maxsimmonds1337/RocketClock/software/helpers/artemis.jpg

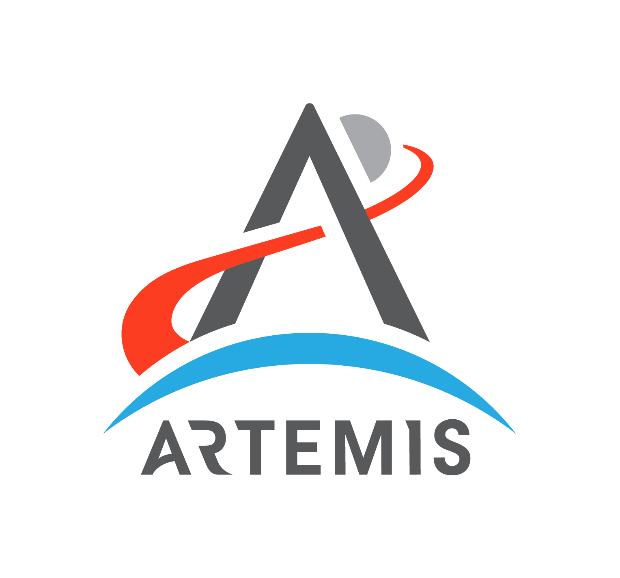
software/helpers/artemis.jpg
