maxsimmonds1337/RocketClock/manufacturing/RocketClock_BOM.csv

Reference | Qty | Value | DNP | Exclude from BOM | Exclude from Board | Footprint | Datasheet
BZ1 | 1 | CBT-09427-SMT-TR |  |  |  | footprints:CUI_CBT-09427-SMT | ~
C1,C2 | 2 | 1uF |  |  |  | Capacitor_SMD:C_0402_1005Metric_Pad0.74x0.62mm_HandSolder | ~
C3,C6,C8,C12,C14,C15 | 6 | 100nF |  |  |  | Capacitor_SMD:C_0402_1005Metric_Pad0.74x0.62mm_HandSolder | ~
C4,C5,C7,C11,C13 | 5 | 10uF |  |  |  | Capacitor_SMD:C_0402_1005Metric_Pad0.74x0.62mm_HandSolder | ~
C9,C10 | 2 | 33pF |  |  |  | Capacitor_SMD:C_0402_1005Metric_Pad0.74x0.62mm_HandSolder | ~
D1,D66 | 2 | D_Schottky |  |  |  | Diode_SMD:D_SOD-123 | ~
D2,D3,D4,D5,D6,D7,D8,D9,D10,D11,D12,D13,D14,D15,D16,D17,D18,D19,D20,D21,D22,D23,D24,D25,D26,D27,D28,D29,D30,D31,D32,D33,D34,D35,D36,D37,D38,D39,D40,D41,D42,D43,D44,D45,D46,D47,D48,D49,D50,D51,D52,D53,D54,D55,D56,D57,D58,D59,D60,D61,D62,D63,D64,D65 | 64 | Green |  |  |  | LED_SMD:LED_0805_2012Metric_Pad1.15x1.40mm_HandSolder | ~
J1 | 1 | PROG_CONN |  |  |  | Connector_PinHeader_1.00mm:PinHeader_1x06_P1.00mm_Vertical_SMD_Pin1Left | ~
J2 | 1 | Right Output Conn |  |  |  | Package_SO:MagConn | ~
J3 | 1 | Left Input Conn |  |  |  | Package_SO:MagConn | ~
JP1 | 1 | SolderJumper_2_Bridged |  | Excluded from BOM |  | Jumper:SolderJumper-2_P1.3mm_Bridged2Bar_RoundedPad1.0x1.5mm | ~
P1 | 1 | INPUT_PWR |  |  |  | Connector_USB:USB_C_Receptacle_GCT_USB4105-xx-A_16P_TopMnt_Horizontal | https://www.usb.org/sites/default/files/documents/usb_type-c.zip
Q1,Q2 | 2 | SS8050 |  |  |  | Package_TO_SOT_SMD:SOT-23 | http://www.secosgmbh.com/datasheet/products/SSMPTransistor/SOT-23/SS8050.pdf
Q3 | 1 | MMBT3906 |  |  |  | Package_TO_SOT_SMD:SOT-23 | https://www.onsemi.com/pdf/datasheet/pzt3906-d.pdf
Q4,Q5,Q6,Q7 | 4 | BC848W |  |  |  | Package_TO_SOT_SMD:SOT-323_SC-70 | http://www.infineon.com/dgdl/Infineon-BC847SERIES_BC848SERIES_BC849SERIES_BC850SERIES-DS-v01_01-en.pdf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
R1,R2,R3 | 3 | 5.1k |  |  |  | Resistor_SMD:R_0402_1005Metric_Pad0.72x0.64mm_HandSolder | ~
R4 | 1 | 14k |  |  |  | Resistor_SMD:R_0402_1005Metric_Pad0.72x0.64mm_HandSolder | ~
R5,R6 | 2 | 470 |  |  |  | Resistor_SMD:R_0402_1005Metric_Pad0.72x0.64mm_HandSolder | ~
R7,R8,R10,R19,R20,R21,R22 | 7 | 10k |  |  |  | Resistor_SMD:R_0402_1005Metric_Pad0.72x0.64mm_HandSolder | ~
R9,R13,R15,R16,R17,R18 | 6 | 330 |  |  |  | Resistor_SMD:R_0402_1005Metric_Pad0.72x0.64mm_HandSolder | ~
R11 | 1 | USER | DNP |  |  | Resistor_SMD:R_0402_1005Metric_Pad0.72x0.64mm_HandSolder | ~
R12 | 1 | 2.2k |  |  |  | Resistor_SMD:R_0402_1005Metric_Pad0.72x0.64mm_HandSolder | ~
R14 | 1 | 100 |  |  |  | Resistor_SMD:R_0402_1005Metric_Pad0.72x0.64mm_HandSolder | ~
SW1 | 1 | SW_Push |  |  |  | Button_Switch_SMD:SW_Push_1P1T_NO_CK_KSC6xxJ | ~
U1 | 1 | TLV75533PDBV |  |  |  | Package_TO_SOT_SMD:SOT-23-5 | http://www.ti.com/lit/ds/symlink/tlv755p.pdf
U2 | 1 | MAX7219 |  |  |  | Package_SO:SOIC-24W_7.5x15.4mm_P1.27mm | https://datasheets.maximintegrated.com/en/ds/MAX7219-MAX7221.pdf
U3 | 1 | TMP112xxDRL |  |  |  | Package_TO_SOT_SMD:SOT-563 | https://www.ti.com/lit/ds/symlink/tmp112.pdf
U4 | 1 | CH340G |  |  |  | Package_SO:SOIC-16_3.9x9.9mm_P1.27mm | http://www.datasheet5.com/pdf-local-2195953
U5 | 1 | ATtiny84A-M |  |  |  | Package_DFN_QFN:QFN-20-1EP_4x4mm_P0.5mm_EP2.6x2.6mm | http://ww1.microchip.com/downloads/en/DeviceDoc/doc8183.pdf
U6 | 1 | ESP-12F |  |  |  | RF_Module:ESP-12E | http://wiki.ai-thinker.com/_media/esp8266/esp8266_series_modules_user_manual_v1.1.pdf
Y1 | 1 | 12MHz |  |  |  | Crystal:Crystal_SMD_3225-4Pin_3.2x2.5mm_HandSoldering | ~
