maxsimmonds1337/RocketClock/manufacturing/LED Positions.dxf

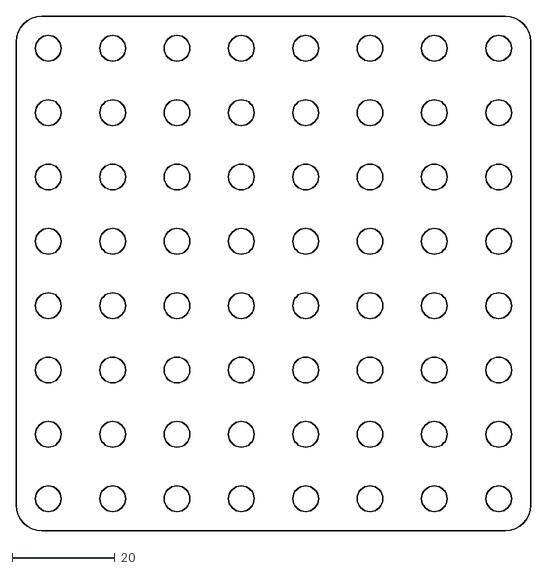
[picture p2: CAD file, 2026-03-16]
manufacturing/LED Positions.dxf
100.0 x 100.0
