maxsimmonds1337/RocketClock/manufacturing/PCB - Sketch 1.dxf

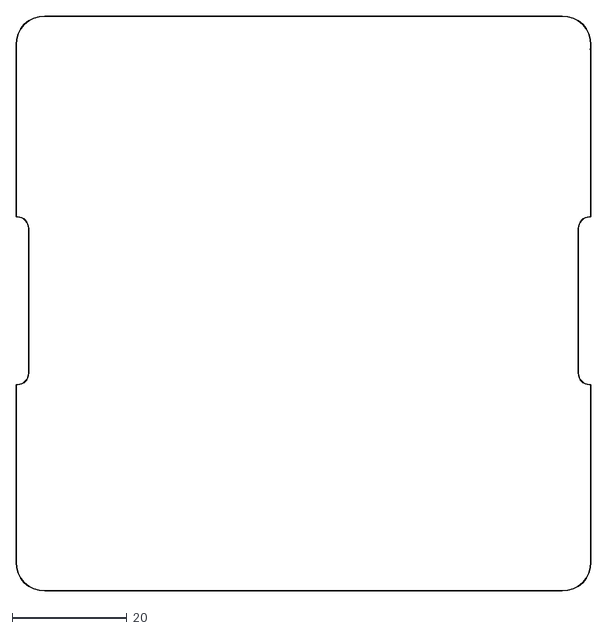
[picture p3: CAD file, 2026-03-01]
manufacturing/PCB - Sketch 1.dxf
100.0 x 100.0
