maxsimmonds1337/RocketClock/manufacturing/RocketClock.pdf

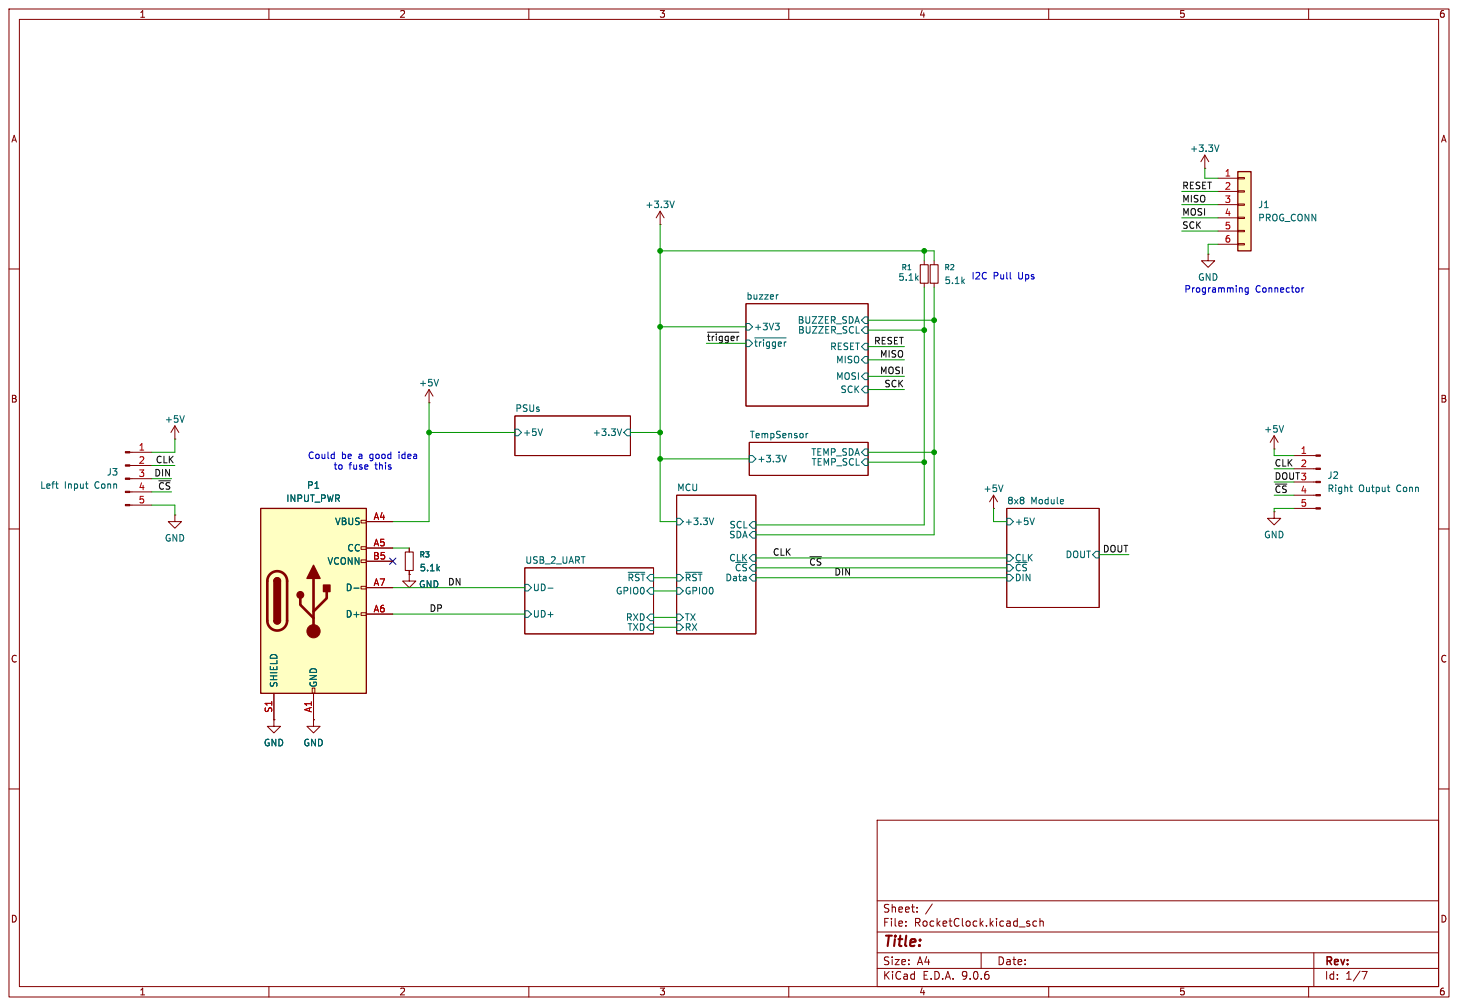
[picture p4: page 1]

~{CS} CLK MOSI SCK RESET Could be a good idea

I2C Pull Ups R35.1k GND GND

Id: 1/7 Title: File: RocketClock.kicad_sch Sheet: /

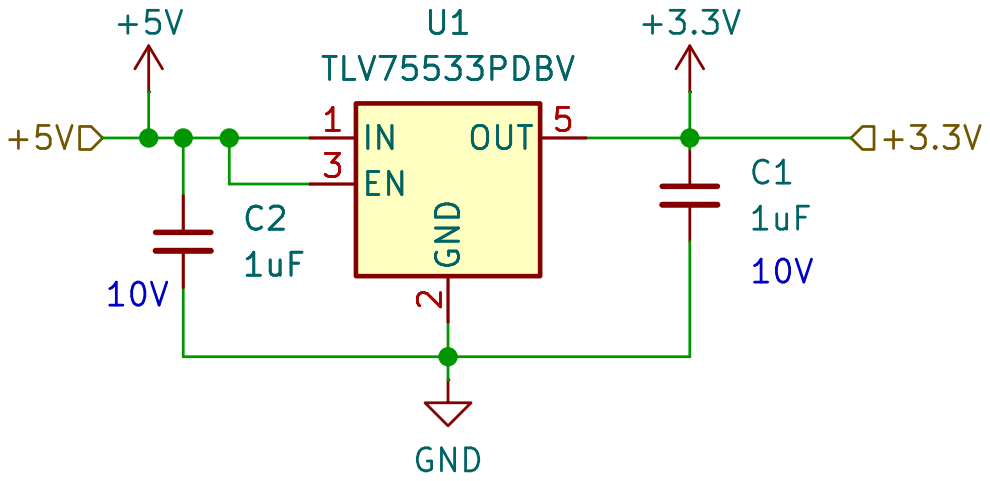
[picture p5: page 2]

Id: 2/7 Title: File: PSUs.kicad_sch Sheet: /PSUs/ GND

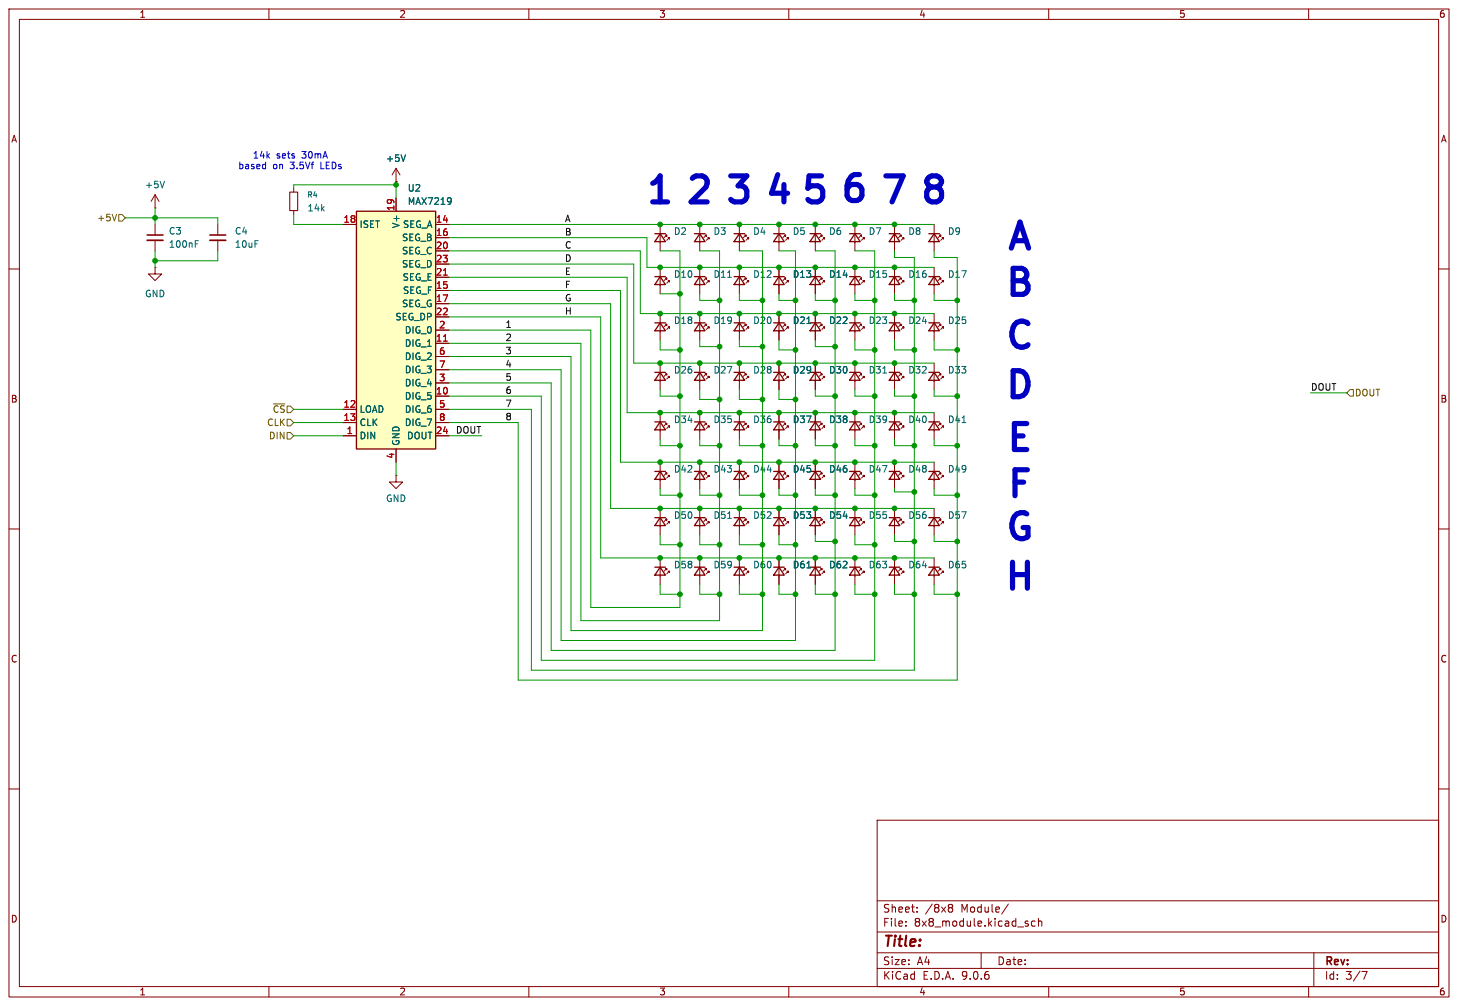
[picture p6: page 3]

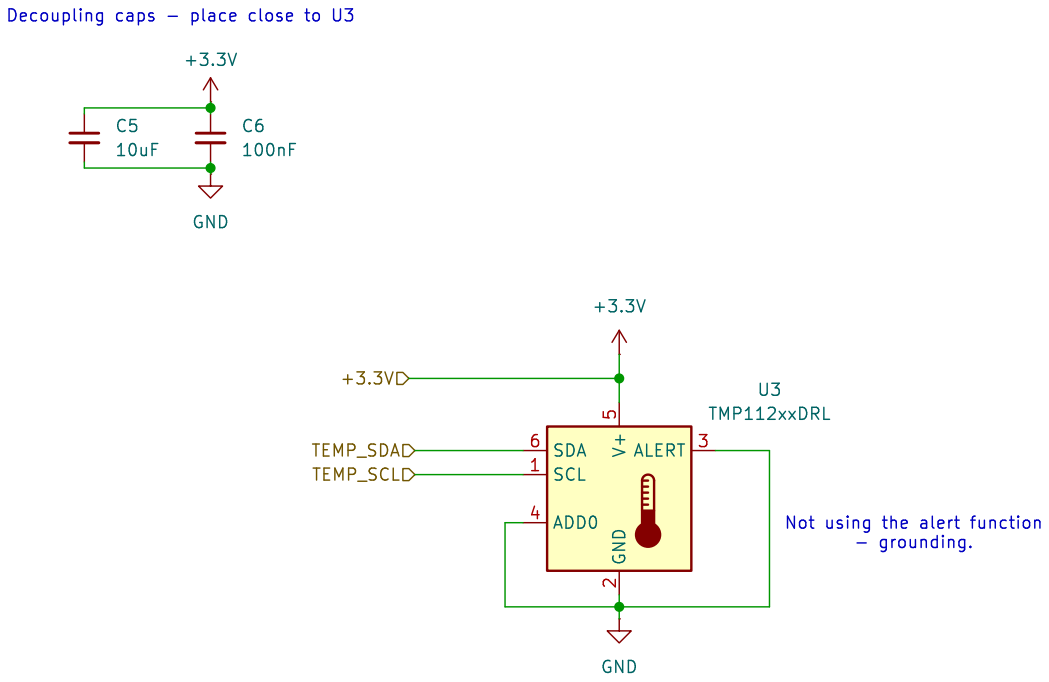
[picture p7: page 4]

Id: 5/7 Title: File: tempSensor.kicad_sch Sheet: /TempSensor/

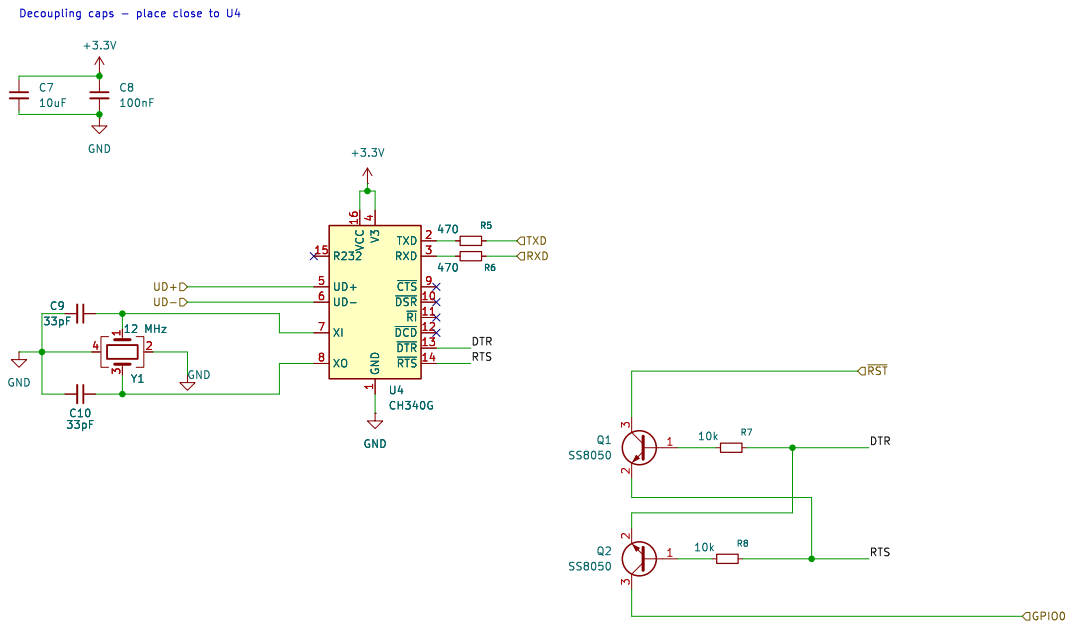
[picture p8: page 5]

1 TXD 2 RXD 3 ~{CTS}9 ~{DSR} 10 ~{RI} 11 ~{DCD} 12 ~{DTR} 13 ~{RTS} 14 C9

1 TXD 2 RXD 3 ~{CTS}9 ~{DSR} 10 ~{RI} 11 ~{DCD} 12 ~{DTR} 13 ~{RTS} 14 U4 CH340G

Id: 6/7 Title: File: usb_2_uart.kicad_sch Sheet: /USB_2_UART/ R8 10k C10

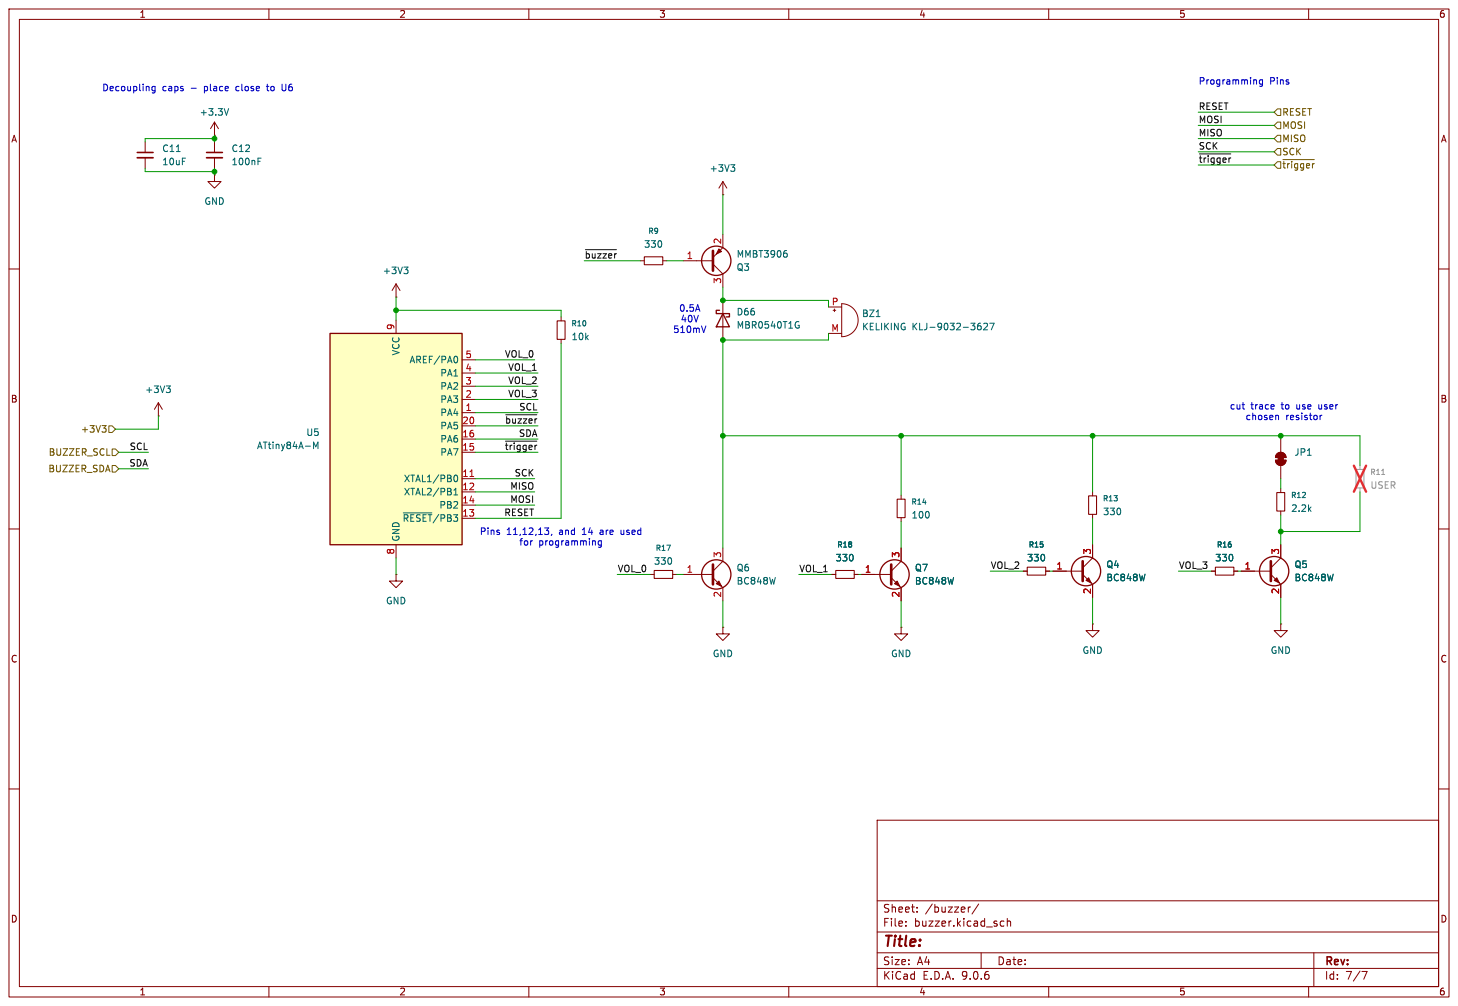
[picture p9: page 6]

Id: 7/7 Title: File: buzzer.kicad_sch Sheet: /buzzer/

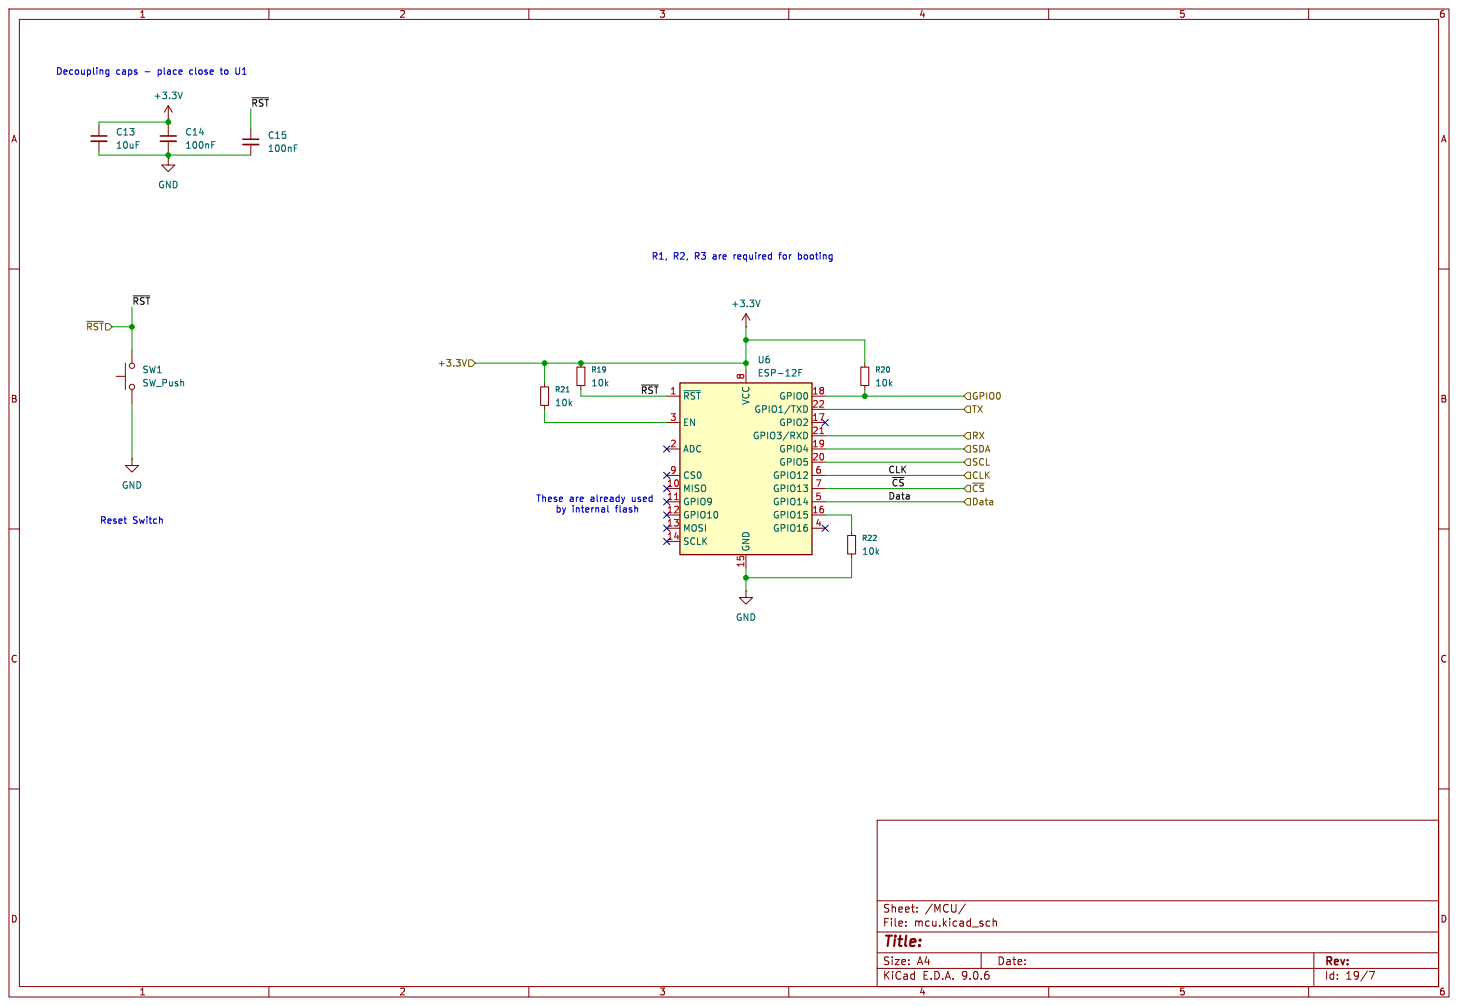
[picture p10: page 7]

Id: 19/7 Title: File: mcu.kicad_sch Sheet: /MCU/
