maxsimmonds1337/RocketClock/design/RocketClock.kicad_pcb

## KiCad design design/RocketClock.kicad_pcb (2026-04-05)

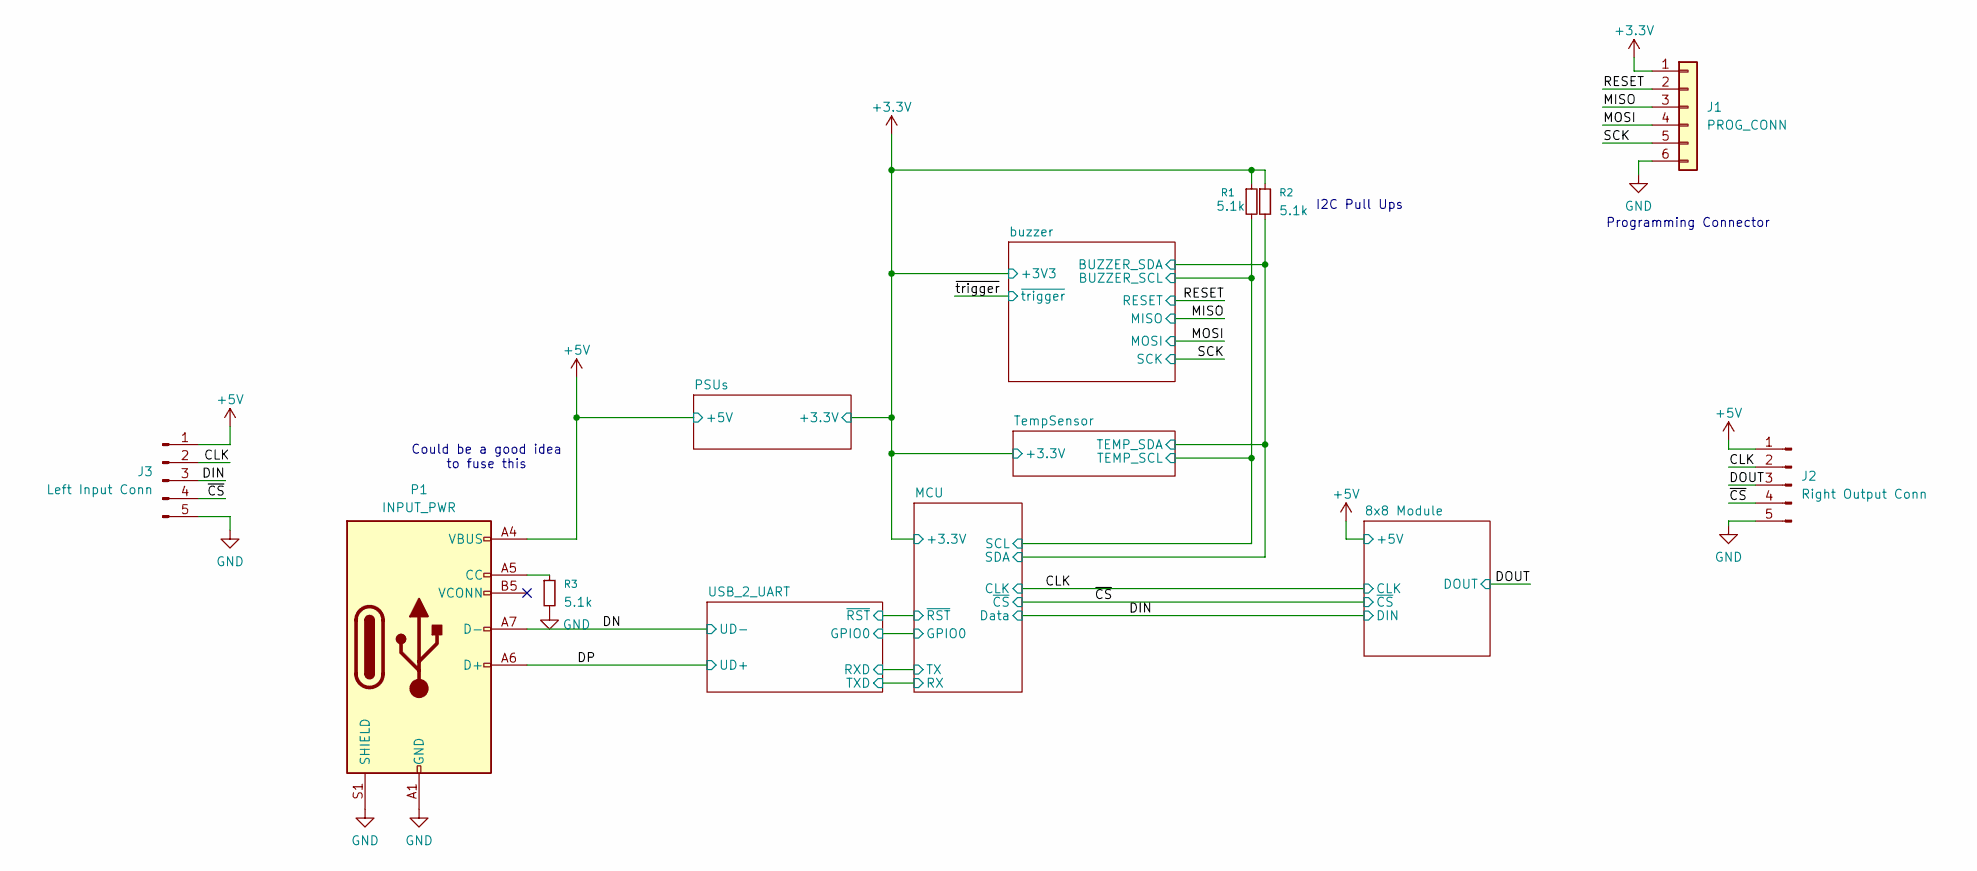
[picture p11: schematic RocketClock.kicad_sch]

Parts:
J1: PROG_CONN; PinHeader_1x06_P1.00mm_Vertical_SMD_Pin1Left
J2: Right Output Conn; MagConn
J3: Left Input Conn; MagConn
P1: INPUT_PWR; USB_C_Receptacle_GCT_USB4105-xx-A_16P_TopMnt_Horizontal
R1, R2, R3: 5.1k; R_0402_1005Metric_Pad0.72x0.64mm_HandSolder

Connections:
+3.3V: J1.1, R1.1, R2.1; also elsewhere on the board
+5V: J2.1, J3.1, P1.A4 (VBUS), P1.A9 (VBUS), P1.B4 (VBUS), P1.B9 (VBUS); also elsewhere on the board
/CLK: J2.2, J3.2; also elsewhere on the board
/DIN: J3.3; also elsewhere on the board
/DN: P1.A7 (D-); also elsewhere on the board
/DOUT: J2.3; also elsewhere on the board
/DP: P1.A6 (D+); also elsewhere on the board
/MISO: J1.3; also elsewhere on the board
/MOSI: J1.4; also elsewhere on the board
/RESET: J1.2; also elsewhere on the board
/SCK: J1.5; also elsewhere on the board
/buzzer/SCL: R1.2; also elsewhere on the board
/buzzer/SDA: R2.2; also elsewhere on the board
/~CS: J2.4, J3.4; also elsewhere on the board
GND: J1.6, J2.5, J3.5, P1.A1 (GND), P1.A12 (GND), P1.B1 (GND), P1.B12 (GND), P1.S1 (SHIELD), R3.2; also elsewhere on the board
unnamed: P1.A5 (CC), R3.1

Notes on the sheet:
Could be a good idea to fuse this
I2C Pull Ups
Programming Connector

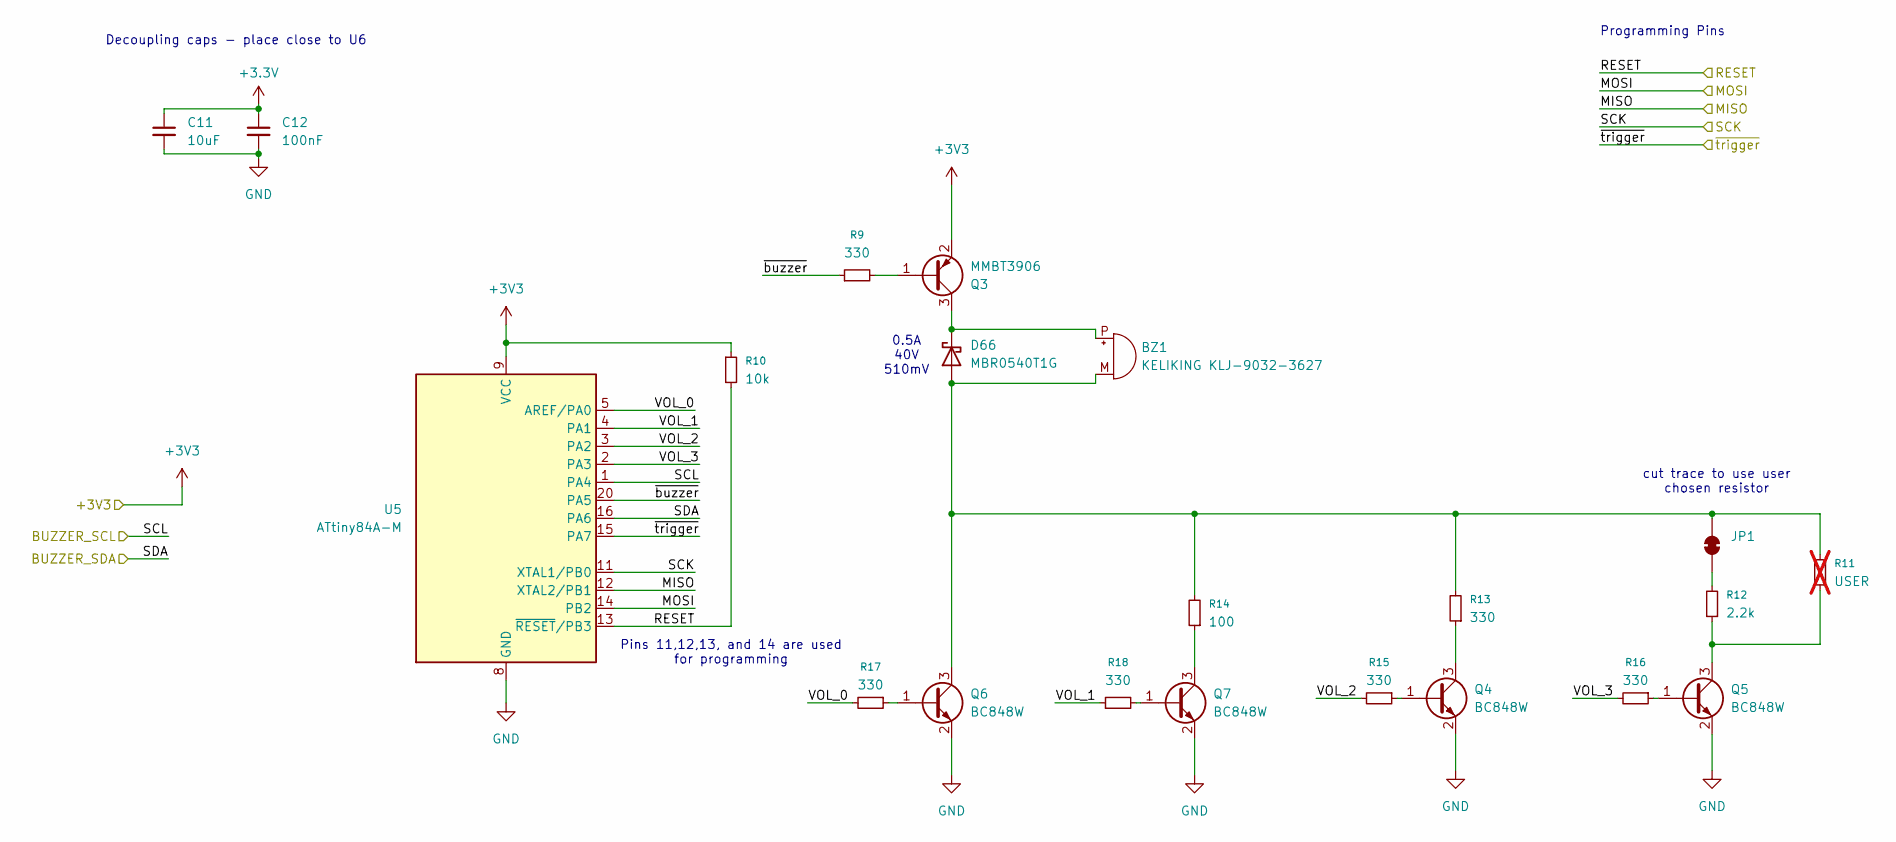
[picture p12: schematic buzzer.kicad_sch]

Parts:
BZ1: KELIKING KLJ-9032-3627; CUI_CBT-09427-SMT
C11: 10uF; C_0402_1005Metric_Pad0.74x0.62mm_HandSolder
C12: 100nF; C_0402_1005Metric_Pad0.74x0.62mm_HandSolder
D66: MBR0540T1G; D_SOD-123
JP1: SolderJumper_2_Bridged; SolderJumper-2_P1.3mm_Bridged2Bar_RoundedPad1.0x1.5mm
Q3: MMBT3906; SOT-23
Q4, Q5, Q6, Q7: BC848W; SOT-323_SC-70
R9, R13, R15, R16, R17, R18: 330; R_0402_1005Metric_Pad0.72x0.64mm_HandSolder
R10: 10k; R_0402_1005Metric_Pad0.72x0.64mm_HandSolder
R11: USER; R_0402_1005Metric_Pad0.72x0.64mm_HandSolder; not fitted
R12: 2.2k; R_0402_1005Metric_Pad0.72x0.64mm_HandSolder
R14: 100; R_0402_1005Metric_Pad0.72x0.64mm_HandSolder
U5: ATtiny84A-M; QFN-20-1EP_4x4mm_P0.5mm_EP2.6x2.6mm

Connections:
+3.3V: C11.1, C12.1, Q3.2 (E), R10.1, U5.9 (VCC); also elsewhere on the board
/MISO: U5.12 (XTAL2/PB1); also elsewhere on the board
/MOSI: U5.14 (PB2); also elsewhere on the board
/RESET: R10.2, U5.13 (~RESET/PB3); also elsewhere on the board
/SCK: U5.11 (XTAL1/PB0); also elsewhere on the board
/buzzer/SCL: U5.1 (PA4); also elsewhere on the board
/buzzer/SDA: U5.16 (PA6); also elsewhere on the board
/buzzer/VOL_0: R17.2, U5.5 (AREF/PA0)
/buzzer/VOL_1: R18.1, U5.4 (PA1)
/buzzer/VOL_2: R15.2, U5.3 (PA2)
/buzzer/VOL_3: R16.2, U5.2 (PA3)
/buzzer/~buzzer: R9.1, U5.20 (PA5)
/~trigger: U5.15 (PA7)
GND: C11.2, C12.2, Q4.2 (E), Q5.2 (E), Q6.2 (E), Q7.2 (E), U5.8 (GND), U5.21 (GND); also elsewhere on the board
unnamed: BZ1.M, D66.2 (A), JP1.2 (B), Q6.3 (C), R11.2, R13.2, R14.2
unnamed: BZ1.P, D66.1 (K), Q3.3 (C)
unnamed: JP1.1 (A), R12.2
unnamed: Q3.1 (B), R9.2
unnamed: Q4.1 (B), R15.1
unnamed: Q4.3 (C), R13.1
unnamed: Q5.1 (B), R16.1
unnamed: Q5.3 (C), R11.1, R12.1
unnamed: Q6.1 (B), R17.1
unnamed: Q7.1 (B), R18.2
unnamed: Q7.3 (C), R14.1

Notes on the sheet:
Pins 11,12,13, and 14 are used for programming
0.5A 40V 510mV
cut trace to use user chosen resistor
Programming Pins
Decoupling caps - place close to U6

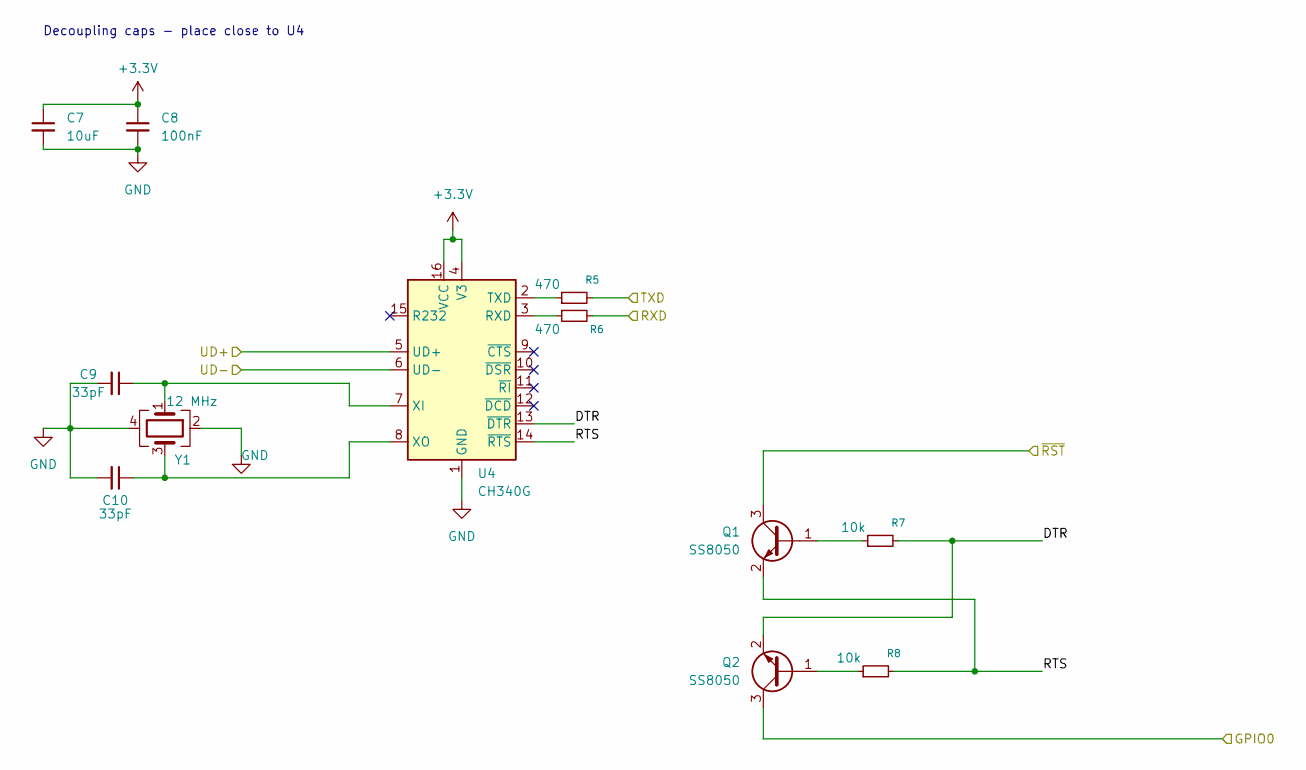
[picture p13: schematic usb_2_uart.kicad_sch]

Parts:
C7: 10uF; C_0402_1005Metric_Pad0.74x0.62mm_HandSolder
C8: 100nF; C_0402_1005Metric_Pad0.74x0.62mm_HandSolder
C9, C10: 33pF; C_0402_1005Metric_Pad0.74x0.62mm_HandSolder
Q1, Q2: SS8050; SOT-23
R5, R6: 470; R_0402_1005Metric_Pad0.72x0.64mm_HandSolder
R7, R8: 10k; R_0402_1005Metric_Pad0.72x0.64mm_HandSolder
U4: CH340G; SOIC-16_3.9x9.9mm_P1.27mm
Y1: 12 MHz; Crystal_SMD_3225-4Pin_3.2x2.5mm_HandSoldering

Connections:
+3.3V: C7.1, C8.1, U4.4 (V3), U4.16 (VCC); also elsewhere on the board
/DN: U4.6 (UD-); also elsewhere on the board
/DP: U4.5 (UD+); also elsewhere on the board
/MCU/GPIO0: Q2.3 (C); also elsewhere on the board
/MCU/RX: R5.2; also elsewhere on the board
/MCU/TX: R6.2; also elsewhere on the board
/MCU/~RST: Q1.3 (C); also elsewhere on the board
/USB_2_UART/DTR: Q2.2 (E), R7.2, U4.13 (~DTR)
/USB_2_UART/RTS: Q1.2 (E), R8.2, U4.14 (~RTS)
GND: C7.2, C8.2, C9.2, C10.2, U4.1 (GND), Y1.2, Y1.4; also elsewhere on the board
unnamed: Q1.1 (B), R7.1
unnamed: Q2.1 (B), R8.1
unnamed: R6.1, U4.3 (RXD)
unnamed: R5.1, U4.2 (TXD)
unnamed: C9.1, U4.7 (XI), Y1.1
unnamed: C10.1, U4.8 (XO), Y1.3

Notes on the sheet:
Decoupling caps - place close to U4

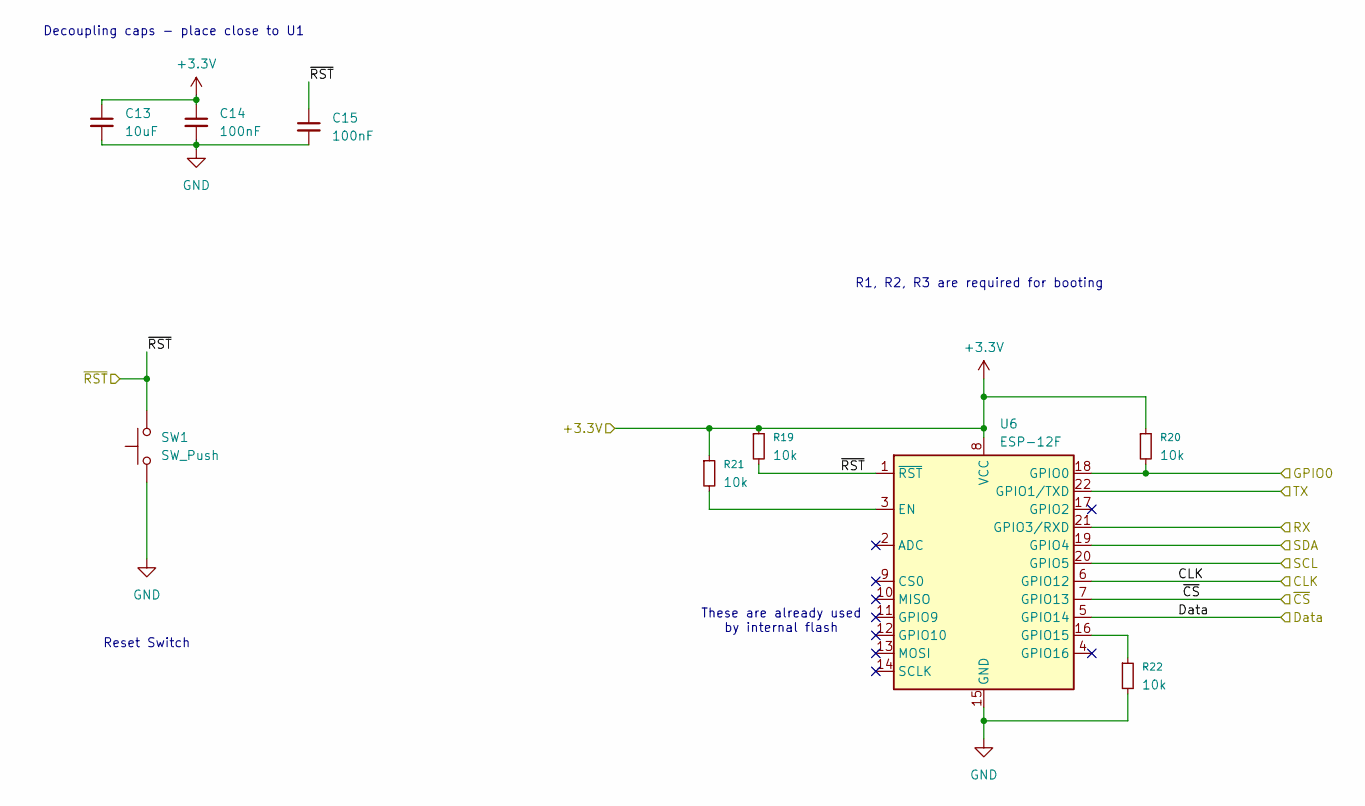
[picture p14: schematic mcu.kicad_sch]

Parts:
C13: 10uF; C_0402_1005Metric_Pad0.74x0.62mm_HandSolder
C14, C15: 100nF; C_0402_1005Metric_Pad0.74x0.62mm_HandSolder
R19, R20, R21, R22: 10k; R_0402_1005Metric_Pad0.72x0.64mm_HandSolder
SW1: SW_Push; SW_Push_1P1T_NO_CK_KSC6xxJ
U6: ESP-12F; ESP-12E

Connections:
+3.3V: C13.1, C14.1, R19.1, R20.1, R21.1, U6.8 (VCC); also elsewhere on the board
/CLK: U6.6 (GPIO12); also elsewhere on the board
/DIN: U6.5 (GPIO14); also elsewhere on the board
/MCU/GPIO0: R20.2, U6.18 (GPIO0); also elsewhere on the board
/MCU/RX: U6.21 (GPIO3/RXD); also elsewhere on the board
/MCU/TX: U6.22 (GPIO1/TXD); also elsewhere on the board
/MCU/~RST: C15.1, R19.2, SW1.2, U6.1 (~RST); also elsewhere on the board
/buzzer/SCL: U6.20 (GPIO5); also elsewhere on the board
/buzzer/SDA: U6.19 (GPIO4); also elsewhere on the board
/~CS: U6.7 (GPIO13); also elsewhere on the board
GND: C13.2, C14.2, C15.2, R22.2, SW1.1, U6.15 (GND); also elsewhere on the board
unnamed: R21.2, U6.3 (EN)
unnamed: R22.1, U6.16 (GPIO15)

Notes on the sheet:
Reset Switch
These are already used by internal flash
Decoupling caps - place close to U1
R1, R2, R3 are required for booting

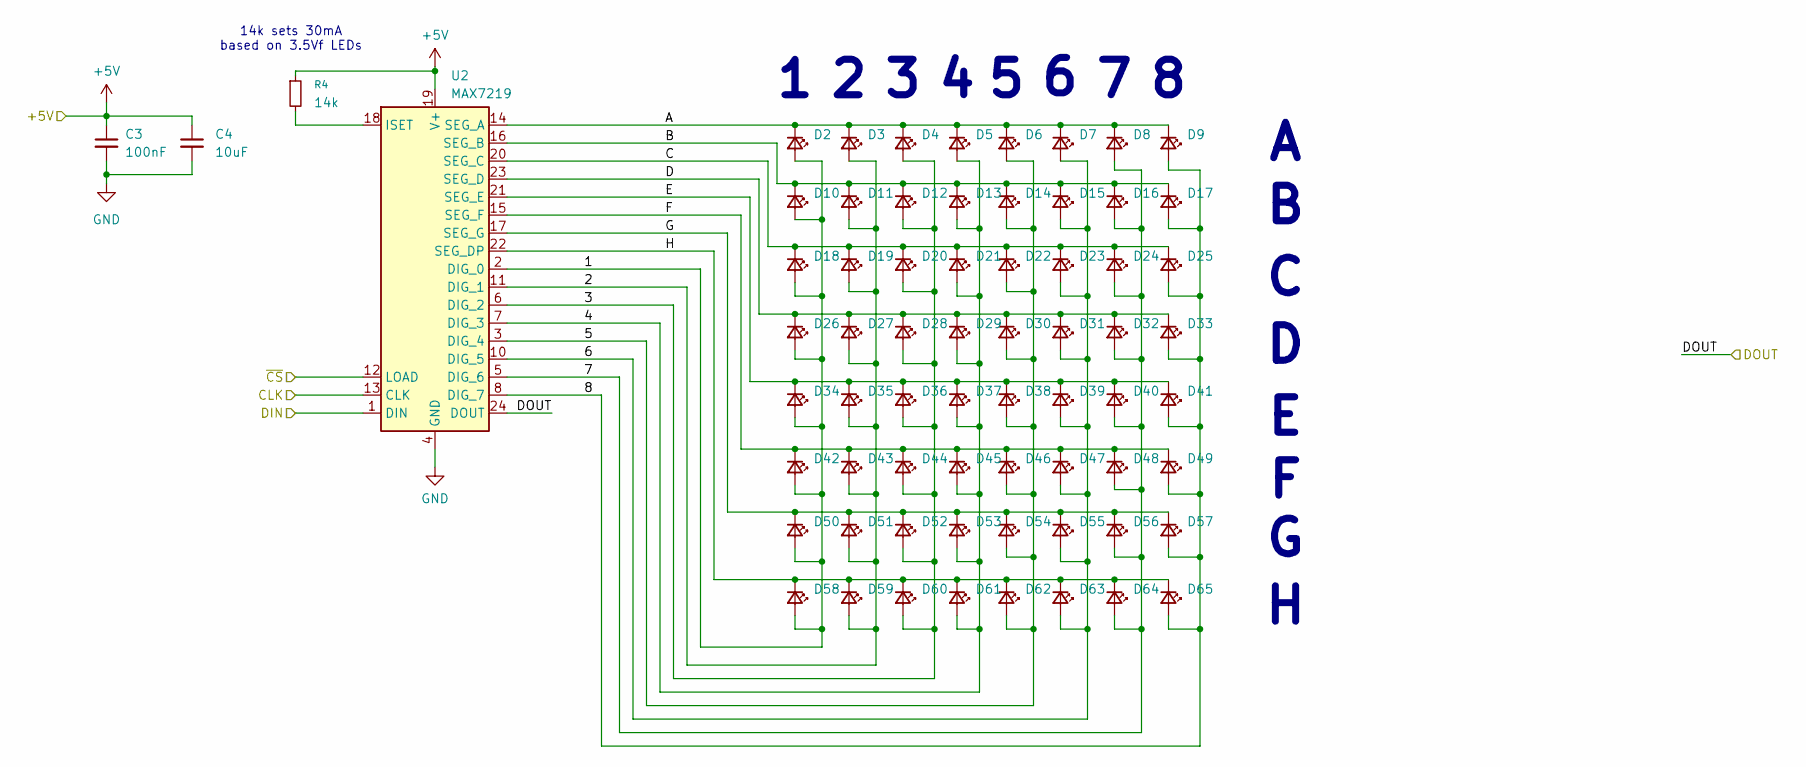
[picture p15: schematic 8x8_module.kicad_sch]

Parts:
C3: 100nF; C_0402_1005Metric_Pad0.74x0.62mm_HandSolder
C4: 10uF; C_0402_1005Metric_Pad0.74x0.62mm_HandSolder
D2, D3, D4, D5, D6, D7, D8, D9, D10, D11, D12, D13, D14, D15, D16, D17, D18, D19, D20, D21, D22, D23, D24, D25, D26, D27, D28, D29, D30, D31, D32, D33, D34, D35, D36, D37, D38, D39, D40, D41, D42, D43, D44, D45, D46, D47, D48, D49, D50, D51, D52, D53, D54, D55, D56, D57, D58, D59, D60, D61, D62, D63, D64, D65: Green; LED_0805_2012Metric_Pad1.15x1.40mm_HandSolder
R4: 14k; R_0402_1005Metric_Pad0.72x0.64mm_HandSolder
U2: MAX7219; SOIC-24W_7.5x15.4mm_P1.27mm

Connections:
+5V: C3.1, C4.1, R4.1, U2.19 (V+); also elsewhere on the board
/8x8 Module/1: D2.2 (A), D10.2 (A), D18.2 (A), D26.2 (A), D34.2 (A), D42.2 (A), D50.2 (A), D58.2 (A), U2.2 (DIG_0)
/8x8 Module/2: D3.2 (A), D11.2 (A), D19.2 (A), D27.2 (A), D35.2 (A), D43.2 (A), D51.2 (A), D59.2 (A), U2.11 (DIG_1)
/8x8 Module/3: D4.2 (A), D12.2 (A), D20.2 (A), D28.2 (A), D36.2 (A), D44.2 (A), D52.2 (A), D60.2 (A), U2.6 (DIG_2)
/8x8 Module/4: D5.2 (A), D13.2 (A), D21.2 (A), D29.2 (A), D37.2 (A), D45.2 (A), D53.2 (A), D61.2 (A), U2.7 (DIG_3)
/8x8 Module/5: D6.2 (A), D14.2 (A), D22.2 (A), D30.2 (A), D38.2 (A), D46.2 (A), D54.2 (A), D62.2 (A), U2.3 (DIG_4)
/8x8 Module/6: D7.2 (A), D15.2 (A), D23.2 (A), D31.2 (A), D39.2 (A), D47.2 (A), D55.2 (A), D63.2 (A), U2.10 (DIG_5)
/8x8 Module/7: D8.2 (A), D16.2 (A), D24.2 (A), D32.2 (A), D40.2 (A), D48.2 (A), D56.2 (A), D64.2 (A), U2.5 (DIG_6)
/8x8 Module/8: D9.2 (A), D17.2 (A), D25.2 (A), D33.2 (A), D41.2 (A), D49.2 (A), D57.2 (A), D65.2 (A), U2.8 (DIG_7)
/8x8 Module/A: D2.1 (K), D3.1 (K), D4.1 (K), D5.1 (K), D6.1 (K), D7.1 (K), D8.1 (K), D9.1 (K), U2.14 (SEG_A)
/8x8 Module/B: D10.1 (K), D11.1 (K), D12.1 (K), D13.1 (K), D14.1 (K), D15.1 (K), D16.1 (K), D17.1 (K), U2.16 (SEG_B)
/8x8 Module/C: D18.1 (K), D19.1 (K), D20.1 (K), D21.1 (K), D22.1 (K), D23.1 (K), D24.1 (K), D25.1 (K), U2.20 (SEG_C)
/8x8 Module/D: D26.1 (K), D27.1 (K), D28.1 (K), D29.1 (K), D30.1 (K), D31.1 (K), D32.1 (K), D33.1 (K), U2.23 (SEG_D)
/8x8 Module/E: D34.1 (K), D35.1 (K), D36.1 (K), D37.1 (K), D38.1 (K), D39.1 (K), D40.1 (K), D41.1 (K), U2.21 (SEG_E)
/8x8 Module/F: D42.1 (K), D43.1 (K), D44.1 (K), D45.1 (K), D46.1 (K), D47.1 (K), D48.1 (K), D49.1 (K), U2.15 (SEG_F)
/8x8 Module/G: D50.1 (K), D51.1 (K), D52.1 (K), D53.1 (K), D54.1 (K), D55.1 (K), D56.1 (K), D57.1 (K), U2.17 (SEG_G)
/8x8 Module/H: D58.1 (K), D59.1 (K), D60.1 (K), D61.1 (K), D62.1 (K), D63.1 (K), D64.1 (K), D65.1 (K), U2.22 (SEG_DP)
/CLK: U2.13 (CLK); also elsewhere on the board
/DIN: U2.1 (DIN); also elsewhere on the board
/DOUT: U2.24 (DOUT); also elsewhere on the board
/~CS: U2.12 (LOAD); also elsewhere on the board
GND: C3.2, C4.2, U2.4 (GND), U2.9 (GND); also elsewhere on the board
unnamed: R4.2, U2.18 (ISET)

Notes on the sheet:
14k sets 30mA based on 3.5Vf LEDs

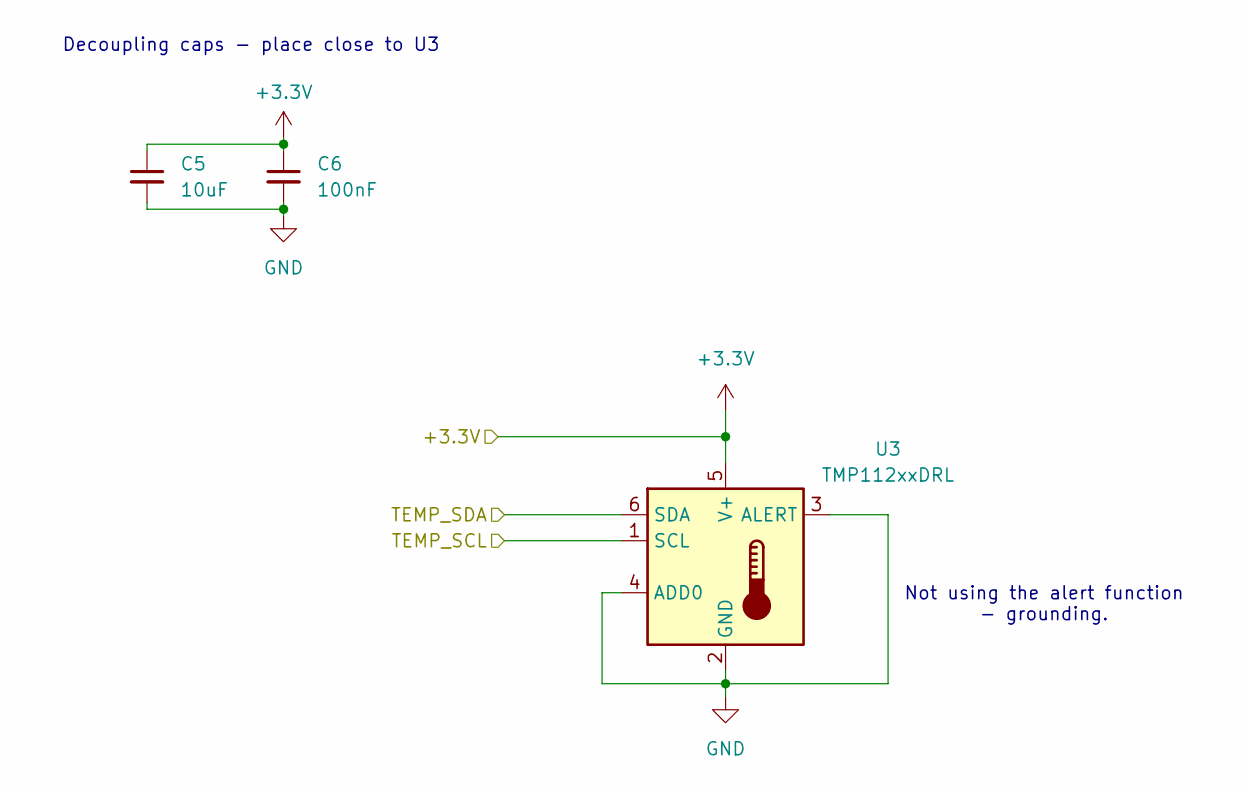
[picture p16: schematic tempSensor.kicad_sch]

Parts:
C5: 10uF; C_0402_1005Metric_Pad0.74x0.62mm_HandSolder
C6: 100nF; C_0402_1005Metric_Pad0.74x0.62mm_HandSolder
U3: TMP112xxDRL; SOT-563

Connections:
+3.3V: C5.1, C6.1, U3.5 (V+); also elsewhere on the board
/buzzer/SCL: U3.1 (SCL); also elsewhere on the board
/buzzer/SDA: U3.6 (SDA); also elsewhere on the board
GND: C5.2, C6.2, U3.2 (GND), U3.3 (ALERT), U3.4 (ADD0); also elsewhere on the board

Notes on the sheet:
Not using the alert function - grounding.
Decoupling caps - place close to U3

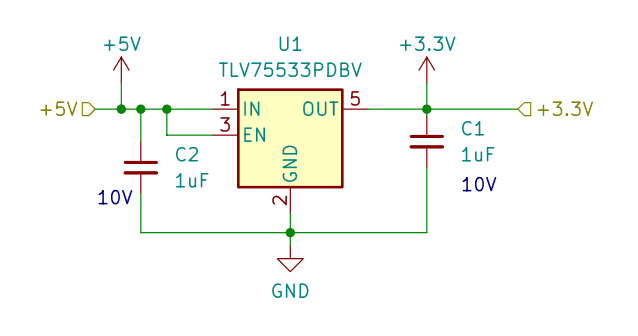
[picture p17: schematic PSUs.kicad_sch]

Parts:
C1, C2: 1uF; C_0402_1005Metric_Pad0.74x0.62mm_HandSolder
U1: TLV75533PDBV; SOT-23-5

Connections:
+3.3V: C1.1, U1.5 (OUT); also elsewhere on the board
+5V: C2.1, U1.1 (IN), U1.3 (EN); also elsewhere on the board
GND: C1.2, C2.2, U1.2 (GND); also elsewhere on the board

Notes on the sheet:
10V

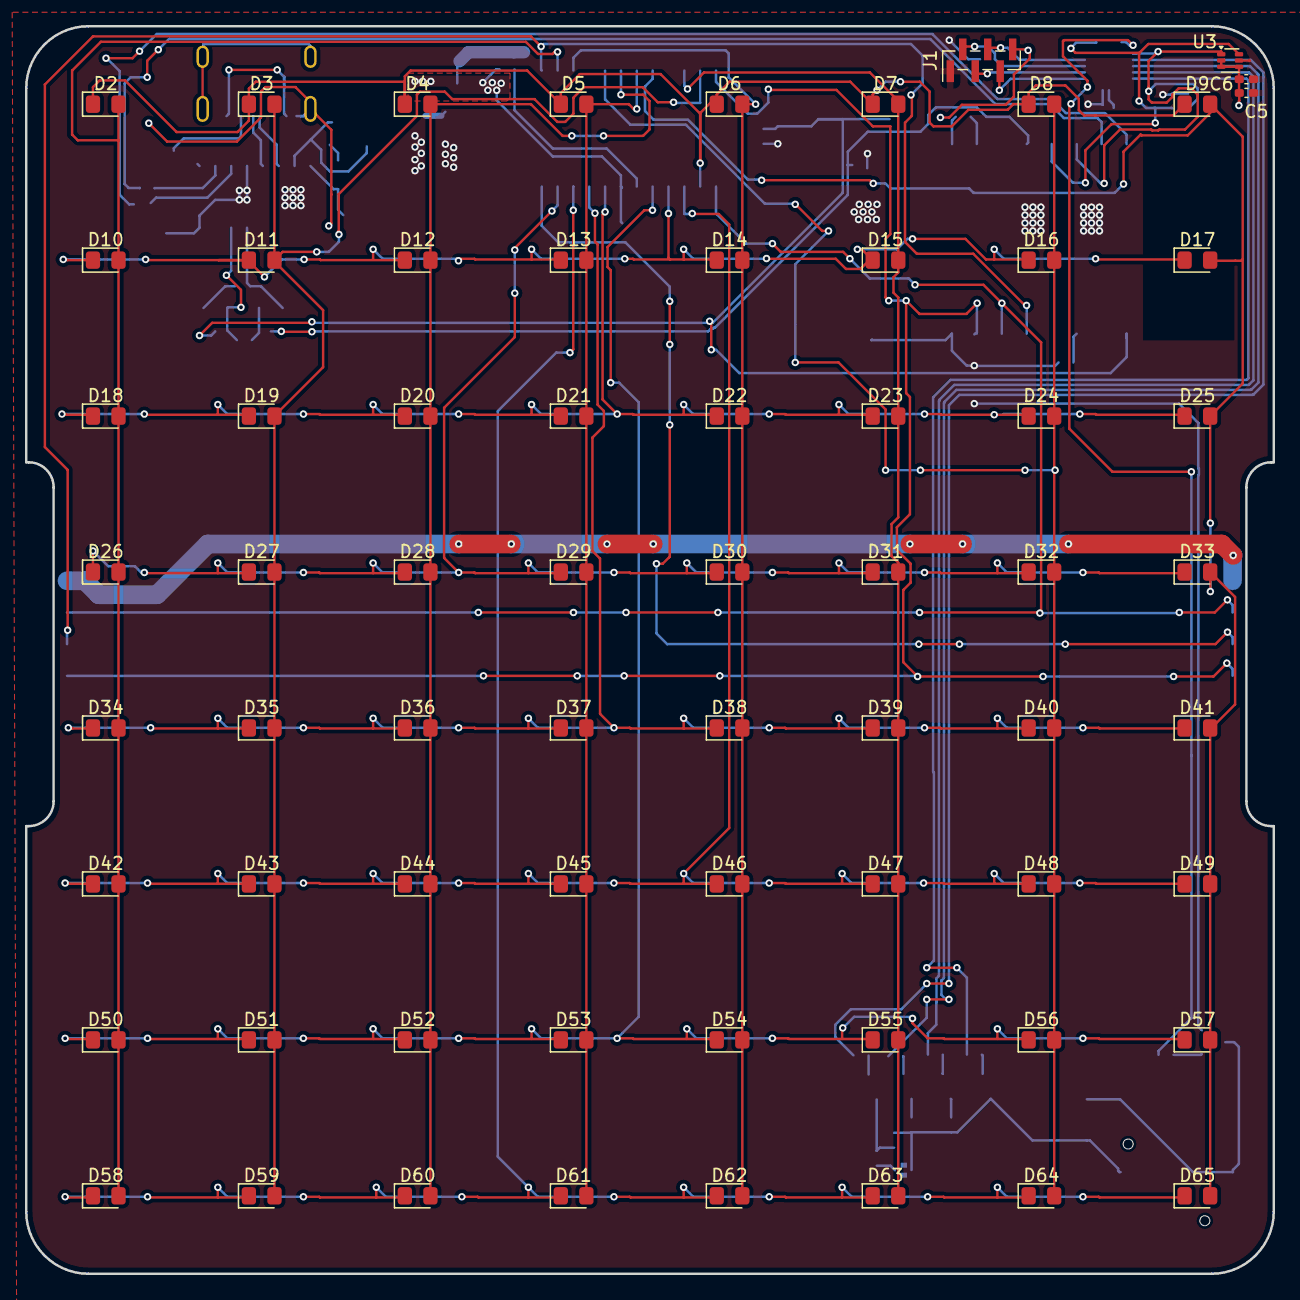
[picture p18: board RocketClock.kicad_pcb from above]

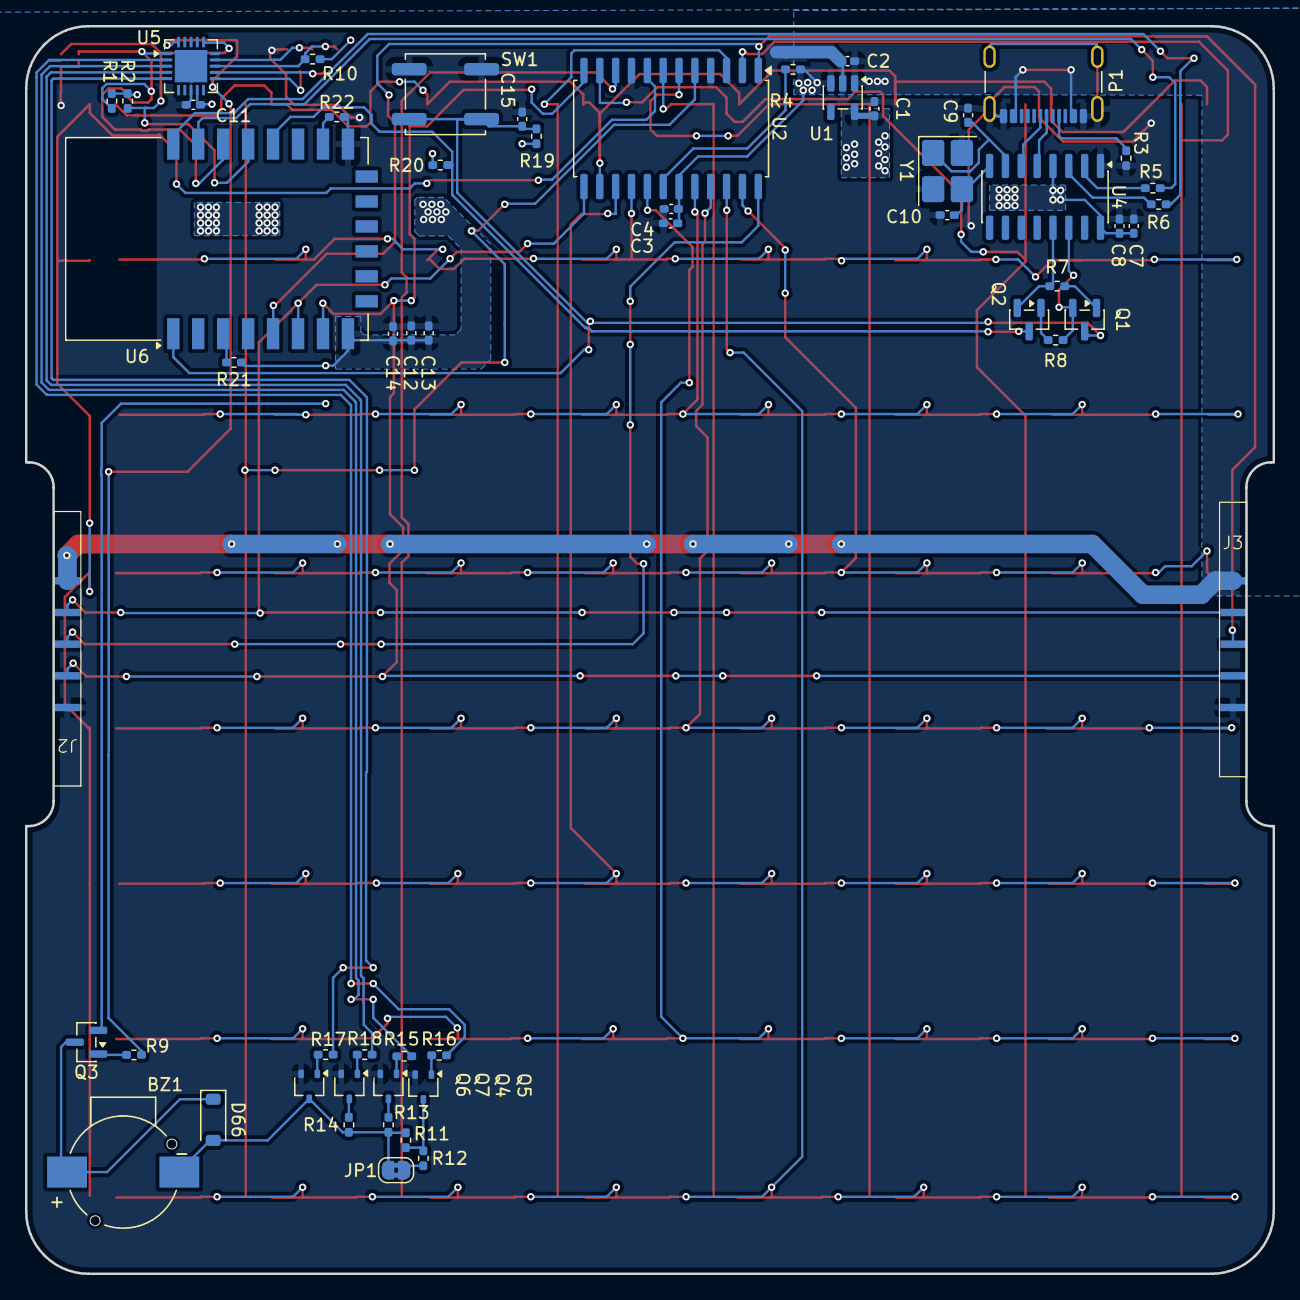
[picture p19: board RocketClock.kicad_pcb from below]

Board: 2 copper layers, 100.0 x 100.0 mm, 123 parts (55 on the bottom side), 63 nets.
