maxsimmonds1337/RocketClock/(commit log)

2026-02-24 Schematic Capture
    This commit adds the schematic capture (no PCB layout) for the rocket clock. It might change, but this is a first good version.
    [8x8_module.kicad_sch, PSUs.kicad_sch, RocketClock.kicad_pcb, RocketClock.kicad_sch, mcu.kicad_sch, tempSensor.kicad_sch, usb_2_uart.kicad_sch]
2026-03-01 Added some more sheets, new board layout
    [8x8_module.kicad_sch, PSUs.kicad_sch, RocketClock.kicad_pcb, RocketClock.kicad_sch, RocketClockPCBOutline.dxf, buzzer.kicad_sch, mcu.kicad_sch, tempSensor.kicad_sch]
2026-03-16 layout mostly done, schematic is done, need to generate new updated pdf
    [8x8_module.kicad_sch, LED Positions.dxf, PCB - Sketch 1.dxf, PSUs.kicad_sch, RocketClock.kicad_pcb, RocketClock.kicad_sch, buzzer.kicad_sch, mcu.kicad_sch]
2026-03-21 Layout and Schematic Done
    Almost ready for first release with tag. DRC etc passing, DFM checks pass on JLCPCB, but I need to go through sourcing components and ensure we have them all available before pushing the button on the orders
    [RocketClock-B_Cu.gbl, RocketClock-B_Mask.gbs, RocketClock-B_Paste.gbp, RocketClock-B_Silkscreen.gbo, RocketClock-Edge_Cuts.gm1, RocketClock-F_Cu.gtl, RocketClock-F_Mask.gts, RocketClock-F_Paste.gtp]
2026-03-23 Update design and manufacturing files for v1.0.0 release
    [RocketClock-B_Cu.gbl, RocketClock-B_Mask.gbs, RocketClock-B_Paste.gbp, RocketClock-B_Silkscreen.gbo, RocketClock-Edge_Cuts.gm1, RocketClock-F_Cu.gtl, RocketClock-F_Mask.gts, RocketClock-F_Paste.gtp]
2026-03-23 Add board bring-up test procedure
    Comprehensive test document covering:
    - Pre-power visual inspection and continuity checks
    - Power supply verification (5V/3.3V rails)
    - USB-to-Serial (CH340G) testing
    - ESP-12F boot and flash verification
    - I2C bus and TMP112 temperature sensor tests
    - MAX7219 LED matrix validation
    - Buzzer/ATtiny84A testing
    - Full system integration tests
    - Known issues verification checklist
    - Troubleshooting guide
2026-04-05 added ibom and some software
    [RocketClock.kicad_pcb]
2026-09-10 Add RocketClock firmware: LED driver libs, test sketches, WiFi control server
    Firmware libraries (software/lib, shared via --libraries):
    - RocketMatrix: MAX7219 8x8 driver. Fixes the no-decode segment-bit remap so
    logical (col,row) maps correctly (root-caused an off-by-one fill). Multi-panel
    support with serpentine + 180-deg reverse-row flip for chained modules.
    - RocketFont: full 8x8 glyph set (upper/lower/digits/punct/degree/pound) from
    public-domain font8x8, proportional spacing, x-offset primitive for scrolling.
    - RocketBuzzer: I2C SparkFun Qwiic Buzzer (ATtiny84 @0x34) + named melodies.
    Test sketches (software/tests): timer (fill + Hedwig finale), rotate (axis-angle
    + perspective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
    [alphabet.ino, buzzer_test.ino, esp12f_server.ino, font.ino, led_scan.ino, orientation.ino]
2026-09-11 Fix boot init, add mission-control dashboard + serial-over-WiFi telemetry
    - RocketMatrix::begin(): fix the "random all-LEDs-lit at boot" bug by configuring
    and clearing while shut down, enabling the display last, and forcing
    display-test off (chip powers up with random display data).
    - Server: revamp dashboard as a mission-control UI (CONTROL/TELEMETRY tabs, live
    CONNECTED/OFFLINE indicator, panel styling), and stream serial output over
    WiFi via a log ring buffer + /api/logs polled by the telemetry console.
    Claude-Session: https://claude.ai/code/session_019YgyHCTspbeX8eWknGnfZN
    [esp12f_server.ino]
2026-09-11 Persist config; overhaul timer; global flip; air proxy; siren; UI fixes
    - Persistence: config saved to LittleFS (ArduinoJson, debounced), loaded at boot;
    FQBN given an FS partition (eesz=4M1M). Survives power-cycle.
    - Timer overhaul: fills the whole COLS*8 x ROWS*8 canvas (not just 64); clears/
    fills at start so it's visible; configurable fill order (rows/cols/snake-rows/
    snake-cols/panel); forward or reverse (empty-off); one-shot non-blocking finale
    (switch mode to reset - no power-cycle); configurable end sound + SIREN default.
    - Global 180 display flip (RocketMatrix::setFlip180) for USB-down mounting.
    - Air quality via Cloudflare proxy (rocketclock-air): direct Open-Meteo TLS OOM'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
    [esp12f_server.ino]
2026-09-11 Add event engine + news feed
    Event engine: events = {trigger -> ordered sequence of timed actions}, persisted
    to LittleFS. Triggers: AT_TIME, IN_RANGE, THRESHOLD (temp/AQI >/< X), DELTA
    (value changes by >= X). Actions (text/weather/news/mars/air/clock/temp/buzzer)
    each run for N cycles or N seconds, reusing existing renderers; the sequencer
    takes over the display on trigger then returns to the base mode. New EVENTS
    dashboard tab builds/edits/deletes events. Verified on hardware (threshold fired
    a buzzer+text sequence).
    News: BBC RSS trimmed to a headline by a Cloudflare proxy (rocketclock-news);
    new `news` mode + `A_NEWS` action.
    Cla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
    [esp12f_server.ino]
2026-09-11 Fix HTTPS OOM crash on mars/news/launch/air (MFLN small TLS buffers)
    The event engine's extra RAM pushed BearSSL's default 16KB RX buffer past the
    ESP8266 heap ceiling, so any HTTPS feed fetch crash-rebooted the board. All
    feeds go through Cloudflare proxies, which support max-fragment-length, so
    client.setBufferSizes(2048, 512) shrinks the TLS buffers ~14KB and the fetches
    now fit. Verified: mars + news run with no reboot (BOOT count stays 1).
    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
    [esp12f_server.ino]
2026-09-11 Fix jsonVal truncating string values at commas (news showed one word)
    jsonVal stopped at the first comma, so a headline like "Spies, strategies..."
    became "Spies". Now quoted values are read to their closing quote (commas kept);
    bare numeric values still stop at the delimiter. Fixes news; harmless for the
    numeric mars/air fields.
    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
    [esp12f_server.ino]
2026-09-17 Clock: render static & centred when it fits (e.g. 4-wide HH:MM), else scroll
    Adds RocketFont::drawCentered (centres both axes, auto-tightens gap 1->0 so
    HH:MM fits a 32px-wide display) and textWidthGap. Clock mode draws static &
    centred when the string fits the canvas width, only redrawing when the minute
    changes; falls back to scrolling on narrow displays. Verified on 4x2 (32x16):
    "16:05" static-centred.
    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
    [esp12f_server.ino]
